matheus-1618/Esta-o_Meteorol-gica_Arduino/README.md

# Esta-o_Meteorol-gica_Arduino
Grupo: Adney Costa, Matheus Oliveira e Ykaro Andrade
* Estação que ilustrava medidas de temperatura,umidade,pressão,altitude com sensores ligados a Arduino uno.
* Projeto realizado para a disciplina do primeiro semestre do Insper, Insturmentação e Medição, com intuito mor em discutir técnicas de calibração e medição de sensores, sobretudo arduino e práticas de programação simples em Wiring, baseada sobretudo em C e C++.
* Neste repositório encontram-se também relatórios e planilhas de calibração de sensores, utilizando métodos simples como o Minimo Quadrado dos erros.
