matheus-1618/Esta-o_Meteorol-gica_Arduino/Relatório prático da estação/Relatório Estação Metereológica-Matheus,Adney,Ykaro.pdf

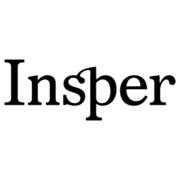
[picture p1: figure]

### Relatório Técnico

### Projeto de uma Estação Meteorológica

### Instrumentação e Medição

### Turma 1A

### Adney Costa Moura

### Matheus Silva Melo de Oliveira

### Ykaro de Sousa Andrade

### São Paulo,2020

# Objetivos e Introdução

Neste relatório será demonstrado todos os passos de como fora a montagem de Estação Meteorológica, controlada por um microcontrolador Arduino Uno, bem como todos os materiais utilizados no processo e a calibração dos respectivos sensores: Sensor de Temperatura LM-35, Sensor de Umidade DHT-22, Sensor de Luz LDR, Sensor de Pressão e Altitude BMP-358. Tudo isso afim de obter uma maior exatidão nos valores medidos em cada um dos experimentos. Para cada uma dessas medições foram realizadas experimentações em laboratório.

Com o objetivo de calibrar o Sensor LM-35 utilizamos 6 fornos, cada um com temperaturas distintas. Para a calibração DHT-22 foi preciso 6 soluções aquosas de sais distintos para a medição de umidade.

O objetivo da montagem desta Estação Meteorológica é obter os dados mais exatos possíveis de Temperatura, Umidade, Luminosidade, Altitude e Pressão e com a utilização de um microcontrolador Arduino e uma Tela LED demonstrar estesresultados, com a menor taxa de erro possível dentre os parâmetros corrigidos.

# Fundamentação teórica

Para a realização desse relatório e alguns de seus procedimentos teóricos foram utilizados conceitos matemáticos e estatísticos que auxiliaram na construção e entendimento dos dados aqui apresentados.

1.Método dos Mínimos Quadrados

Método criado por Carl Friedrich Gauss, com intuito de obter um melhor ajuste para um conjunto de dados, visando sobretudo, minimizar os erros de aproximação. Este método busca aproximar um conjunto de pares ordenados por uma função, onde cada par ordenado tem um erro de aproximação. O “MMQ” minimiza a soma dos erros quadrados, tendendo assim para uma melhor aproximação desse conjunto de dados.

Para o uso deste método, se fazem necessários os cálculos dos seguintes somatórios:

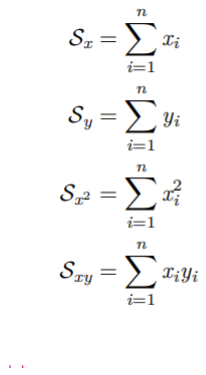
[picture p2: figure]

Posteriormente, foi estabelecido o cálculo da variável intermediária ∆, esta crucial para o estabelecimento dos coeficientes intrínsecos à reta:

∆= n. Sx² − SxSx

a =

1
∆

(nSxy − Sxy)

b =

1
∆

(nSx²Sy − SxSxy)

Definido os coeficientes, devemos definir as retas de calibração e sua função inversa, que dessa forma, permitirão uma correção de um conjunto de dados analisados:

f(x) = ax + b

f

−1

(y) = (

1
a

) . y − (

b
a

)

De posse dessas retas, se faz possível a correção de determinados valores estimados com a correção adequada para tal conjunto de valores.

2.Determinação de incertezas

De acordo com o conjunto de dados analisados, determinadas incertezas são intrínsecas a sua medição, tanto quanto à características próprias do material. Dessa forma, dois tipos de incerteza foram considerados durante todo o processo de análise e correção de conjuntos de dados, estes, posteriormente combinados em um único valor de incerteza, essa sendo considerada padrão para o sistema em questão. A primeira incerteza analisada, é concernente a erros aleatórios, essa sendo considerada como Incerteza estatística ou Incerteza do tipo A, onde seu cálculo é possível através do estabelecimento do desvio padrão da amostra de dados e seu respectivo tamanho. Os passos para sua obtenção, consistem em:

-Cálculo da média aritmética da amostra:

u =

1
n

∑xi

n

i=1
-Cálculo do desvio padrão:

σ = √
1
n − 1

∑(xi − u)²

n

i=1

-Determinação da incerteza estatística:

σa =

σ
√n

Analogamente, se faz necessário o cálculo da incerteza sistemática residual, que usualmente tem seu cálculo através da seguinte fórmula, onde L, é considerado o limite de erro do aparelho:

σb =

L
2

Assim, para a obtenção da incerteza padrão associada ao sistema, basta utilizar:

σp = √σa
2 + σb

2

3.Propagação e Transferência de incertezas

De posse dos valores das incertezas associadas a esse conjunto de valores, é necessário entender como, ao realizar operações matemáticas com dois valores que possuem incertezas, precisamos “propagar” as incertezas associadas. Esse processo, em todas as operações possíveis podem ocorrer conforme a tabela abaixo:

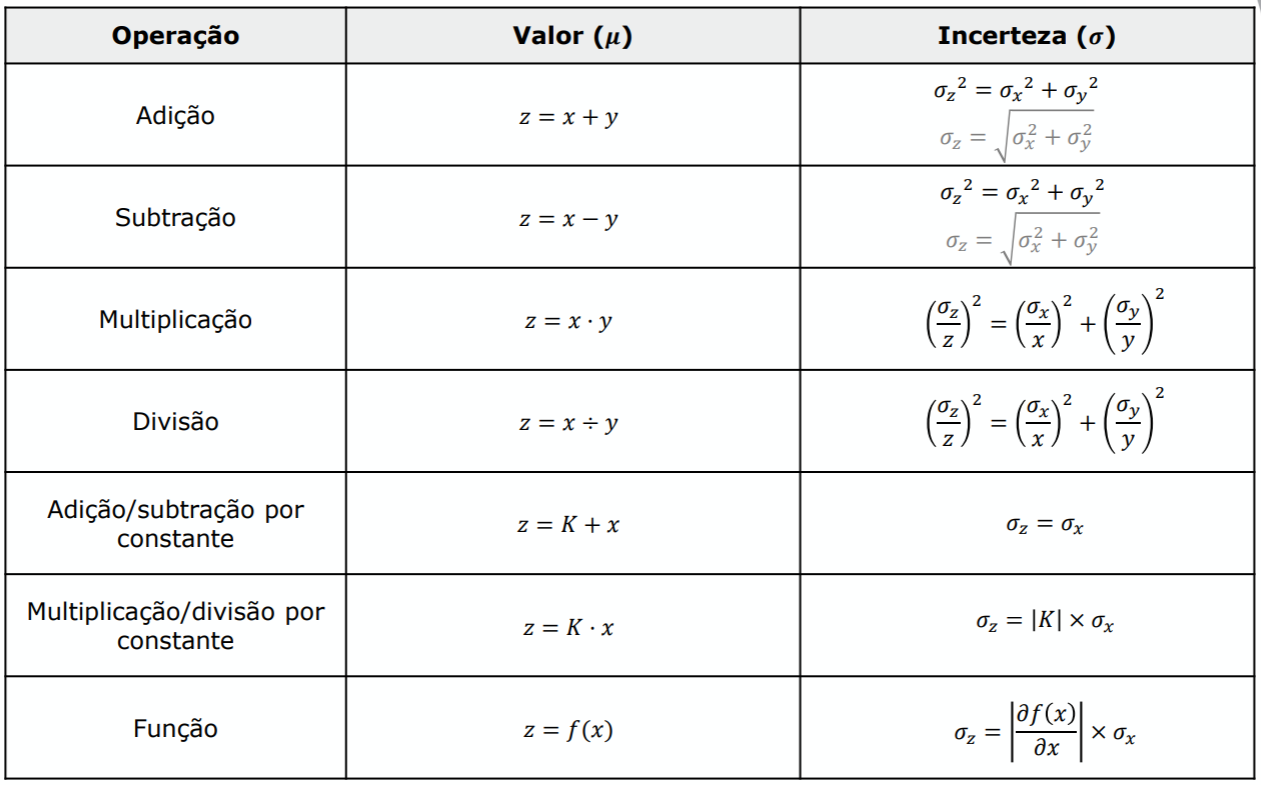
[picture p3: figure]

Eventualmente, determinadas grandezas são medidas em função de determinadas variáveis independentes, sendo que ambas as grandezas podem possuir incertezas associadas. Nesse caso, é necessário admitir-se que a incerteza associada a variável dependente é maior dada pela expressão:

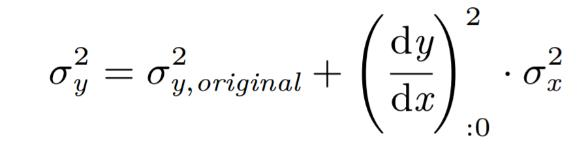
[picture p4: figure]

Assim, utilizando um algoritmo dentro da plataforma Microsoft Excel, se faz possível a transferência de incertezas de eixos.

4.Métódo dos mínimos quadrados com incertezas

Com os valores de incertezas associadas às amostras em mãos, faz-se necessário a adaptação da utilização do MMQ para uma melhor análise disposta do conjunto de dados em questão. Para tal, algumas adaptações algébricas são realizadas e mostradas abaixo, todavia, o algoritmo de resolução da variável intermediária e seus consequentes coeficientes continuam os mesmos.

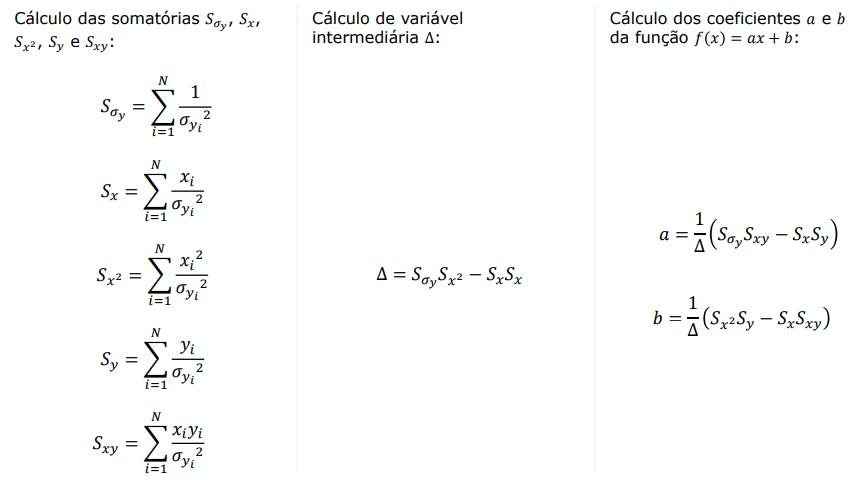
[picture p5: figure]

5.Interpolação e extrapolação

Método que dada a linearidade de uma amostra de dados e seus respectivos valores, pode associar medidas esperadas utilizando tanto valores já definidos, quanto valores esperados pela reta associada. A validade deste método se baseia sobretudo na utilização geométrica de semelhança de triângulos que conseguem prever medidas aproximadas para valores interpolados entre dois pontos conhecidos, como no caso da interpolação ou na suposição de um valor definido e um suposto para com outro esperado entre esses.

# Materiais e métodos

1.Materiais, hadwares e softwares utilizados

A estação é composta de 4 sensores: Temperatura, Altitude e Pressão, Umidade e Luminosidade. Para realizar a calibração de alguns sensores e montagem do projeto foram utilizados os seguintes materiais ou instrumentos:

- 2 Protoboards 830 furos, Breabodboard MB-102;
- 1 resistor de 330ꭥ;
- 1 resistor de 1kꭥ;
- 1 resistor de 10kꭥ;
- 1 Arduino Uno R3 original;
- 1 cabo USB – AB;

-1 display de Cristal Líquido-LCD;

- 1 sensor de Temperatura LM35;
- 1 sensor de umidade DHT 22;
- 1 sensor de luminosidade LDR;
- 1 sensor de altitude e pressão BMP280;
- Termômetro Vidro Líquido Vermelho 5021 Incoterm (53011/15);
- 6 fornos de calibração Ecil;
- 6 Termômetros (Termorresistência) Digital Instrutemp ITTM-917;
- 6 soluções aquosas de sais. Sendo elas:
- Acetato de Potássio
- Cloreto de Magnésio
- Cloreto de Sódio
- Hidróxido de Potássio
- Nitrato de Cálcio
- Cloreto de Potássio

O seguinte software fora utilizado para o registro e análise dos dados coletados durante o experimento: -Microsoft Excel 2016 (pacote Office 2016).

Fora utilizado o software Arduino 1.8.13 para depuração do código utilizado, no qual estão presentes as calibrações realizadas pelos métodos explicados neste relatório posteriormente.

2.Montagem, calibração e métodos utilizados

Inicialmente, fora realizada a calibração do sensor LM35, cujo intuito mor era a medição da temperatura do ambiente. Para esse ajuste, foram realizadas seis medições de temperatura em 6 fornos de calibração, com respectivas temperaturas em 5°C, 15°C, 30°C, 45°C, 60°C e 75°C. Fora adotado um tempo de medição padrão para todas as medições, este estabelecido em aproximadamente quatro minutos. Durante o experimento, os três integrantes da equipe realizaram suas respectivas medições de forma individual e registraram seus resultados no computador, por meio da porta Serial do software Arduino. Porém, para a padronização de todas as aferições, fora escolhido os dados coletados de apenas um dos integrantes, por terem maior proximidade com a realidade. Além disso, fora realizado o trajeto de aferição no sentido do forno com maior temperatura, estimada em 75°C, rumo ao de menor, esperada com temperatura de 5°C, este escolhido com objetivo principal de diminuir o tempo de estabilização do sensor.

Posteriormente, com os dados coletados, fora realizada uma análise e registro na plataforma Microsoft Excel, no qual, após o estabelecimento dos padrões de medição, fora realizada a propagação de incertezas durante o cálculo da média amostral, Desvio padrão e suas respectivas incertezas, do tipo A e B, permitindo assim, uma maior exatidão no estabelecimento da reta de calibração por meio do Método dos Mínimos. Com posse dos dados da reta de calibração, gerando uma função de correção para o valor obtido e pelo real, assim como seus coeficientes, fora possível gerar um padrão de correção, utilizado no código implantado no Arduino.

Subsequentemente, fora realizada a calibração do sensor de umidade, DHT22, utilizando seis soluções salinas, com objetivo de aferir diferentes valores de umidade relativa.

Durante a experiência, foram realizadas seis medições de umidade e temperatura em 6 Becker’s, cada qual contendo uma solução aquosa saturada de seis sais distintos para a calibração e a aferição base do experimento. Fora adotado um tempo de medição padrão para todas as medições, este estabelecido em aproximadamente dez minutos, focado sobretudo na estabilização das medições. Durante o experimento, um dos integrantes da equipe realizou o experimento de forma individual, enquanto os outros dois integrantes realizaram de forma conjunta o registro das medições em seu computador por meio da porta Serial Arduino, depois registrando esses em um documento do tipo CSV, para posterior análise no Excel.

O trajeto de aferição fora escolhido no sentido da solução de menor valor de umidade esperado para o de maior valor de umidade esperado, sendo respectivamente o Hidróxido de Potássio e o Cloreto de Potássio, com objetivo de facilitar a medição, e manter o tempo de estabilização próximo da constância estabelecida previamente.

Ulteriormente, os dados das umidades coletadas foram analisados e registrados na plataforma Microsoft Excel, no qual, fora possível realizar os processos de propagação de incerteza, transferência de incerteza, cálculo das médias das amostras, desvio padrão e as respectivas incertezas de tipo A e B, e dessa forma, o estabelecimento de uma reta de calibração, por meio do Método dos Mínimos Quadrados, que ao minimizar os erros de medição, nos gera uma boa aproximação dos valores corrigidos de umidade registrados para com aqueles condizentes com a realidade.

Realizada a calibração destes dois sensores, fora iniciada a montagem da estação meteorológica, utilizando além dos já citados, um display de cristal líquido e sensores de luminosidade, altitude e pressão; todos esses funcionando sobre o Protocolo I2C, no qual o microcontrolador Arduino Uno R3 funciona como “mestre” para estes, iniciando e controlando a comunicação das portas analógicas de maneira síncrona.

Para a montagem foram utilizadas a porta A0, associado a um resistor de 1kΩ que realizara a leitura de tensão obtida pelo sensor LM35, e suas respectiva conversão para graus Celsius, no qual fora a utilizada a seguinte conversão:

10mV = 1°C

Fora utilizada ainda a resolução de Quantização, utilizando como tensão de alimentação máxima como 1,1 V, e a maior contagem de intervalos discretos, aproximada para:

2

n − 1

Assim, fora possível obter-se uma resolução de discretização, da seguinte forma, sendo 1,1 V, o fundo de escala escolhido:

δ =

1,1
2

n − 1

=

1,1
1023
δ°C ≈ 0,1075°C

Esta última fora fundamental para obtenção da temperatura medida pelo sensor, e que posteriormente sofrera correção pela reta de calibração obtida. De posse dessa última também é possível estimar-se a incerteza associada ao microcontrolador Arduino, do tipo B:

σarduino ≈ 0,2151°C

Assim, de acordo com os dados do fabricante Arduino, e do sensor LM35, teremos as respectivas incertezas associadas.

Combinando essas incertezas, e posteriormente as combinando com a incerteza associada a erros aleatórios de medição fora possível estimar a incerteza padrão associada a cada medição do sensor, este processo contando coma utilização do Método dos Mínimos quadrados, associada as incertezas propagadas durante a realização das operações necessárias à sua calibração.

Posteriormente, fora realizada a montagem do sensor de umidade, DHT22, este ligado na porta pin 2, necessitando do uso de um resistor ôhmico de 10kΩ. Para a medição da umidade relativa em questão era necessário o estabelecimento de uma temperatura de referência, para que, com esta fosse suposta a porcentagem de umidade em relação a umidade máxima naquele momento. Para sua calibração, foram utilizados os processos de interpolação e extrapolação, para suposição de valores intermediários aos de referência, transferência de incertezas, para obtenção de uma incerteza padrão mais próxima da realidade após a transferência desta por eixos distintos conforme mostrado no decorrer deste relatório, e por fim a utilização do Método dos mínimos quadrados associados à propagação de incertezas para obtenção de uma reta de calibração ideal às medições esperadas do sensor.

Subsequentemente, foi iniciada a montagem dos sensores e visor LCD por meio do protocolo I2C, no qual utilizando dois fios, em entradas dos tipos SCL e SDA e dois outros fios de alimentação, provém uma comunicação síncrona entre o microcontrolador e os dispositivos associados a este. Estes
sensores, | respectivamente | BMP | 280 | e | LDR, | foram | responsáveis,
respectivamente, pela aferição de altitude e pressão atmosférica; e luminosidade do ambiente em questão. O sensor de luminosidade LDR, em sua montagem na estação contou com a utilização de um resistor de 330Ω, para assim, diminuir a tensão efetiva neste, e evitar possíveis sobrecargas.

Feita a montagem dos sensores, fora necessário a utilização do visor LCD para ilustração dos valores aferidos em tempo real. Este funcionara com um endereçamento de 16x2, do tipo alfanumérico, especializado em mostrar caracteres do tipo ASCII. Assim, na escrita do algoritmo utilizado era necessário estipular-se o tempo de exibição, tal qual o endereço de exibição em bits do valor requerido

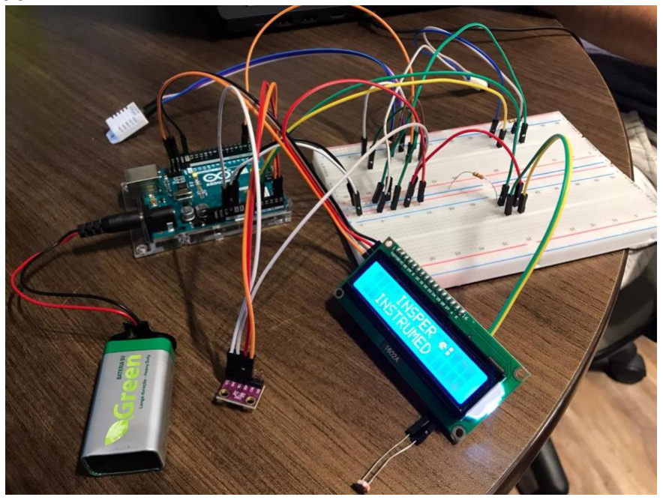
[picture p6: figure]

Figura 1-Visão geral da estação montada

### 3. Programação e algoritmos

Para o eficaz funcionamento da estação, foi necessário a elaboração do código de programação em linguagens C,C++ e C#, por meio da plataforma de prototipagem livre Wiring, em especifico pelo Arduino. Por meio deste código fora possível ajustar as medições previstas pelas retas de calibração obtidas pelos métodos já explicitados, além de ajustar parâmetros de endereçamento e exibição no visor LCD, tornando assim a ilustração dos valores de medição, mais práticos e usuais a aqueles que farão uso da estação.

O código conta com cerca de 3 subdivisões, a primeira na qual são importadas/incluídas as bibliotecas dos sensores e visor utilizados na montagem, além da definição das constantes utilizadas, portas utilizadas, pinagem e confecção de possíveis símbolos não dispostos nos caracteres ASCII, como o símbolo de grau, utilizado na ilustração de temperatura. Posteriormente, foi executada a função void setup(), na qual fora iniciado o programa, assim como o funcionamento dos sensores e visor, tal qual a definição da porta analógica de referência. Por fim, é mostrada a função void loop(), na qual foram definidos os comandos, leituras e medições que serão mostrados de forma indefinida pelo LCD ou monitor Serial. Nele são especificados quais “strings” deveram ser mostradas, tempos de intervalo, conversões realizadas para medições, assim como possíveis definições de fundo de escala ou resoluções.

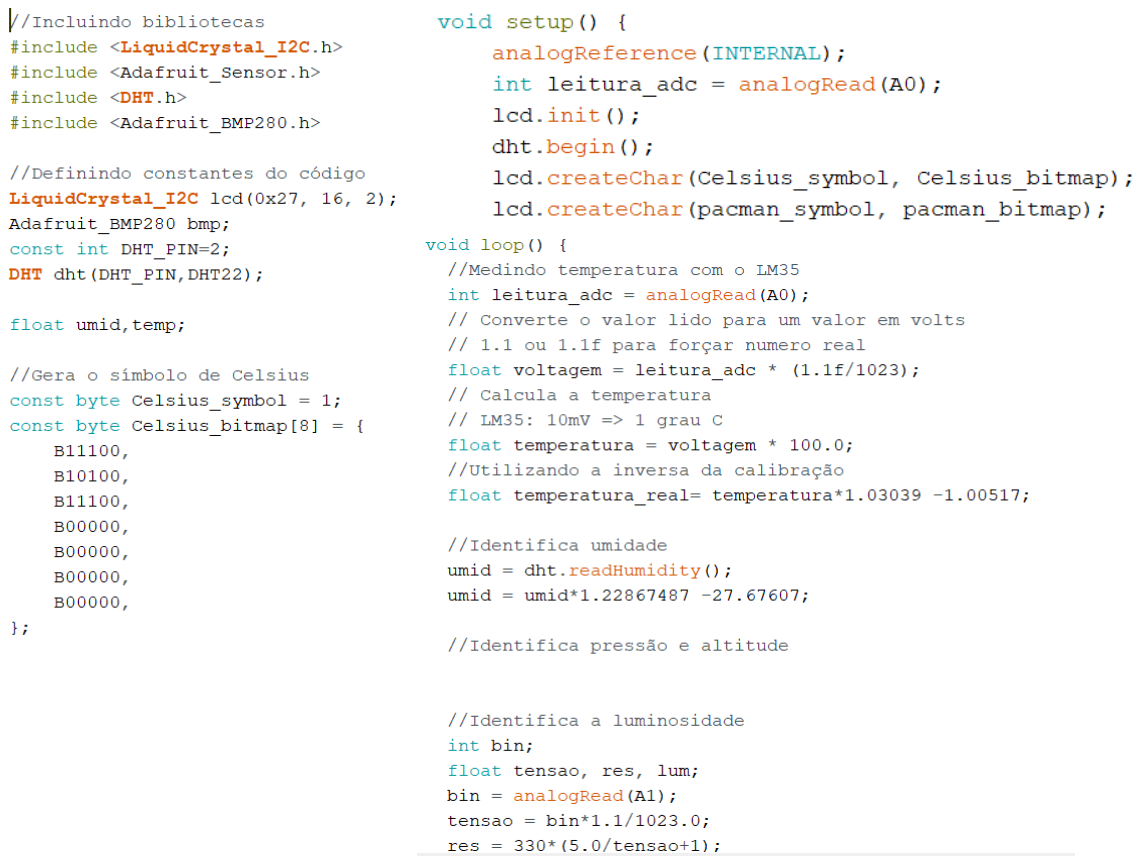
[picture p7: figure]

Figura 2-Parte do código utilizado

# Resultados e discussões

Concomitantemente, foram coletados dados que depois de remetidos às análises, calibrações e montagens, geraram resultados interessantes que possibilitaram a montagem com êxito da estação. Estes resultados foram dividos de acordo com a medição de cada sensor disposto abaixo.

### 1. Sensor de temperatura-LM35

Para a captação dos dados de temperatura registrados pelo sensor LM35, este fora colocado em contato com cerca de 6 fornos de calibração dispostos no laboratório, nas seguintes temperaturas: 5°C, 15°C, 30°C, 45°C, 60°C e 75°C. Ao lado de cada forno havia uma termo resistência que servira como referência para possíveis calibrações em relação ao indicado pelo LM35. Para a medição, fora adotado um tempo médio de espera, estipulado em cerca de 4 minutos para a estabilização das medições. A sequência escolhida para aferição se iniciou do forno de menor temperatura rumo ao de maior temperatura, com intuito de minimizar o tempo de estabilização do sensor, tal qual evitar possíveis erros de medição gerados por uma maior diferença de amplitude nas medições, caso escolhida outra ordem.

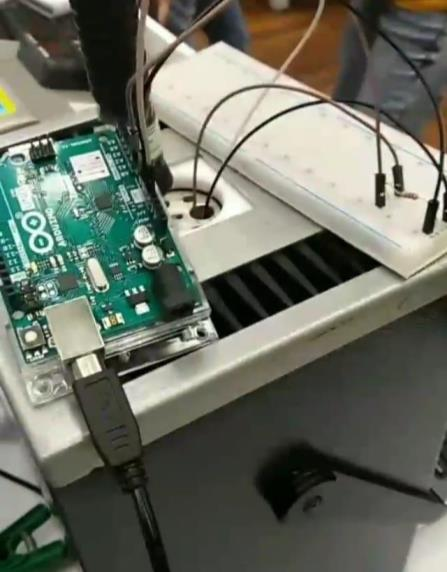
[picture p8: figure]

Figura 3-Sensor registrando a temperatura aproximada em um forno de calibração

Após a coleta dos dados de temperatura para cada um dos fornos, foram consideradas cerca de 5 medições para cada forno. Estes, foram registrados em uma planilha no software Microsoft Excel. Neste também foram registrados os valores de referência, dispostos nas termo resistências auxiliares.

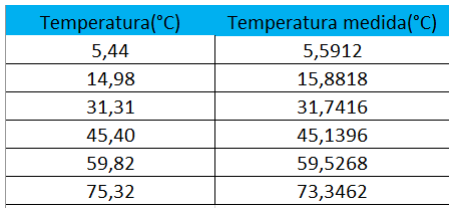
[picture p9: figure]

Tabela 1-Na primeira coluna temos a indicação da temperatura pela termo resistência e na direita, a indicada pelo sensor

Posteriormente, para a estimativa das incertezas associadas, assim como a confecção da reta de calibração, foi realizada, inicialmente, a média aritmética de cada amostra, possibilitando assim, a estimativa do desvio padrão de cada temperatura aferida pelo sensor, e com este, foi possível a estimativa da Incerteza estatística. A incerteza residual sistemática foi estabelecida de acordo com dados fornecidos pelo fabricante, e pelo fundo de escala utilizado, no caso em específico de 1,1V, conforme especificado na seção de Materiais e Métodos.

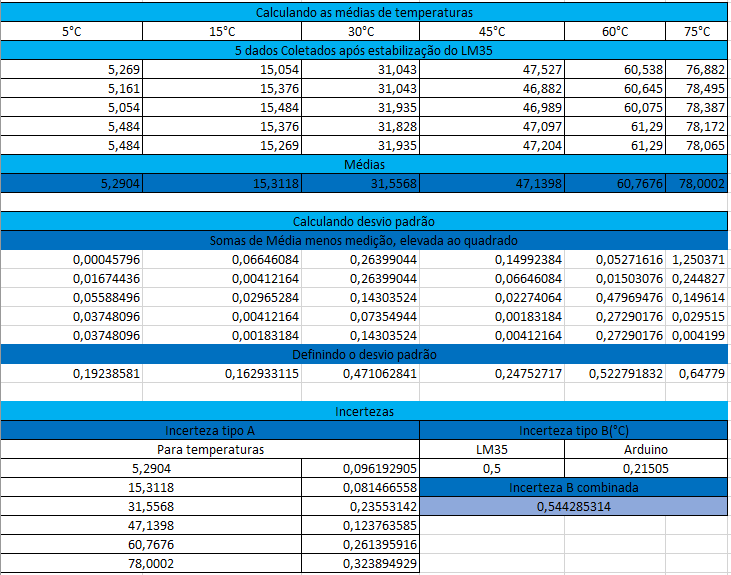
[picture p10: figure]

Tabela 2-Médias aritméticas, Desvio Padrão e Incertezas associadas as amostras.

De posse das incertezas tipo A e B, fora possível combiná-las para obtenção das incertezas padrões de cada temperatura aferida.

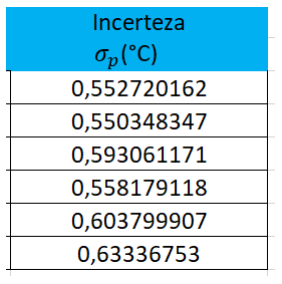
[picture p11: figure]

Tabela 3-Incertezas padrões de cada faixa de temperatura aferida

Destarte, foi possível com a utilização do Método dos Mínimos Quadrados com propagação de incertezas, já explicitado na seção de Fundamentação teórica, foram obtidos os respectivos coeficientes intrínsecos a reta de calibração, necessária para polidez da amostra de dados coletadas.

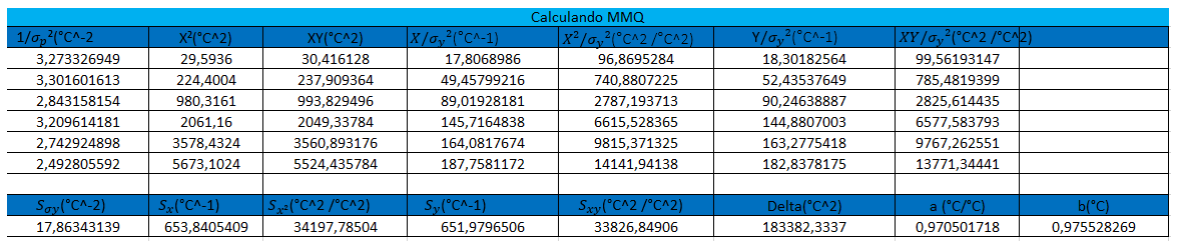
[picture p12: figure]

Tabela 4-Algoritmo de realização dos cálculos pelo MMQ com propagação de incertezas

Dessa forma, foram obtidos tanto a função de calibração, quanto sua inversa, utilizada no código para correção.

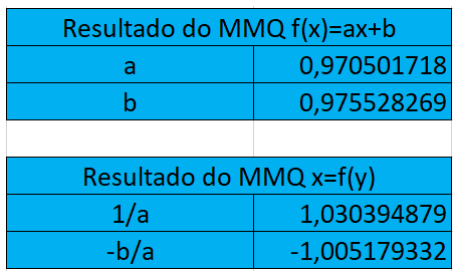
[picture p13: figure]
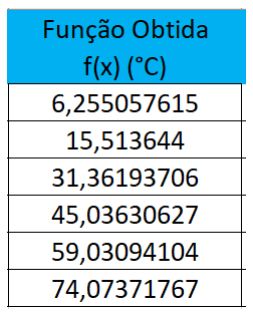
[picture p14: figure]

Tabelas 5 e 6: Equações das retas de calibração, e resultados práticos de calibração para cada ponto amostral.

Dessa forma, fora obtida uma reta de calibração que trouxeram maior proximidade dos dados coletados para com o valor esperado por meio da correção gerada pelos passos explicitados.
Figura 4-Gráfico com representação da reta de calibração

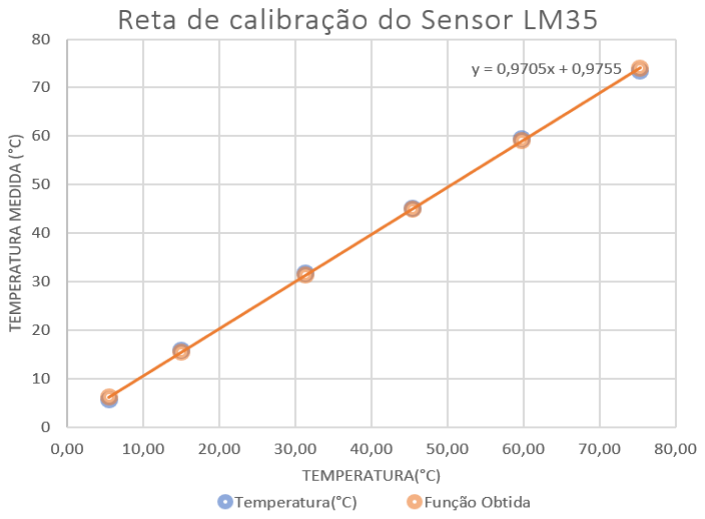
[picture p15: figure]

Em termos práticos, a equação da reta é apresentada abaixo:

y = 0,9705x + 0,9755

Fora realizado a percentualidade do erro relativo nesta medição, em relação a medição esperada, tomando como base a temperatura na faixa de 15°C:

e =

|15 − (0,9705(15) + 0,9755)| (0,9705(15) + 0,9755)

e = 0,0343

Dessa forma, percebe-se que o eixo percentual se encontra próximo de 3,43%, o que se configura com um ótimo grau de razoabilidade da calibração.

No código utilizado para o microcontrolador, essa calibração foi feita aplicando a função inversa da apresentada acima, devido a conversão do valor medido para o esperado. Esta é mostrada a abaixo:

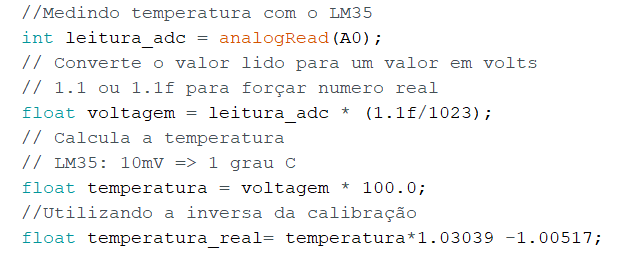
[picture p16: figure]

Figura 5-Parte do código onde ocorre a correção do valor medido

### 2. Sensor de Umidade- DHT22

Tal sensor fora submetido a diferentes porcentagens de umidade relativa, variadas devido a solubilidade das soluções em questão, na qual foram dispostas 6 soluções salinas, estas já apresentadas anteriormente. O sensor fora colocado em recipientes cujo intuito era minimizar o efeito do ambiente sobre a medição no Becker. Dessa forma foram coletadas cerca de 5 medições de umidade para cada solução salina, após sua estabilização. Para tal estabilização, fora definido um tempo comum de aferição estabelecido em volta de 10 minutos. Para minimizar erros experimentais gerados por uma maior diferença de amplitude de medição, fora adotado o sentido de aferir-se as soluções com umidades esperadas mais altas, isto é, próximas de 100%, rumo as baixas, mais próximas de 5%.

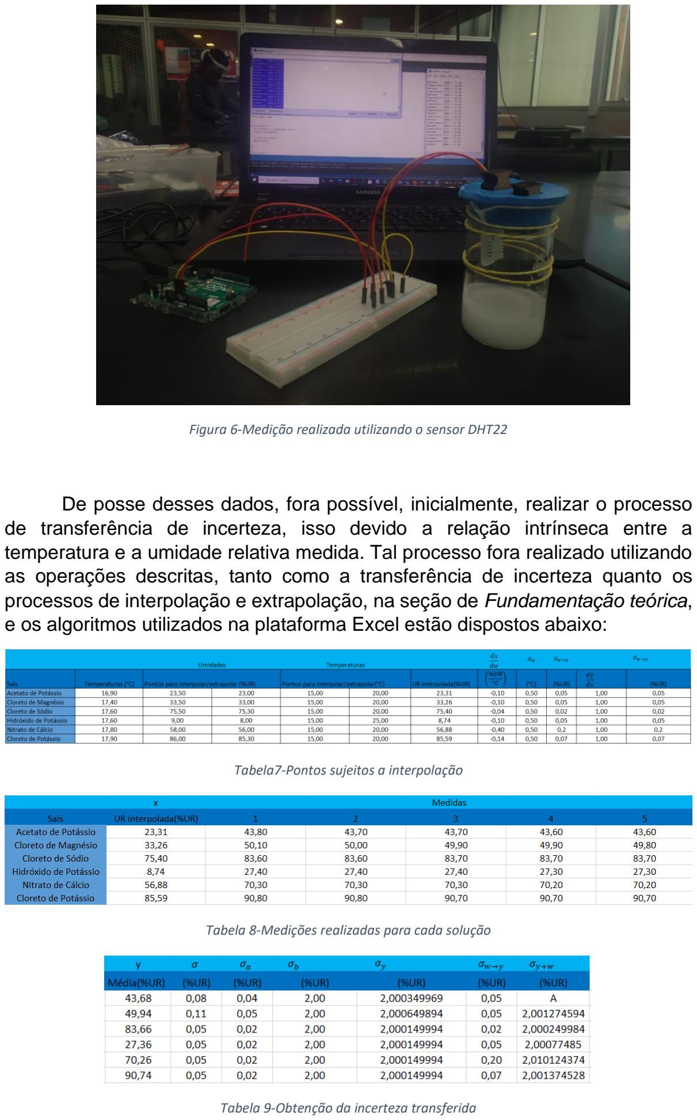
[picture p17: page 16]

Figura 6-Medição realizada utilizando o sensor DHT22

De posse desses dados, fora possível, inicialmente, realizar o processo de transferência de incerteza, isso devido a relação intrínseca entre a temperatura e a umidade relativa medida. Tal processo fora realizado utilizando as operações descritas, tanto como a transferência de incerteza quanto os processos de interpolação e extrapolação, na seção de Fundamentação teórica, e os algoritmos utilizados na plataforma Excel estão dispostos abaixo:

Tabela7-Pontos sujeitos a interpolação

Tabela 8-Medições realizadas para cada solução

Tabela 9-Obtenção da incerteza transferida

Obtida a incerteza transferida padrão, foi possível realizar-se o Método dos Mínimos Quadrados com propagação de incertezas, que dessa forma, pode nos conferir uma reta de calibração que trouxera maior proximidade dos dados coletados para com as referências estipuladas.

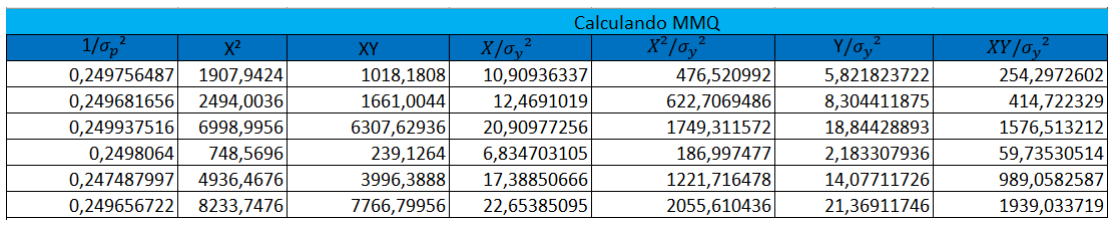
[picture p18: figure]
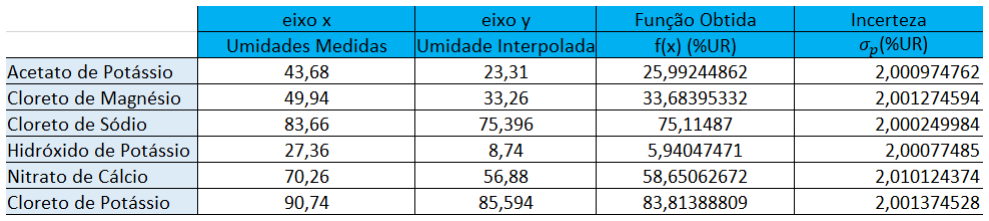
[picture p19: figure]

Tabela 13-Comparação entre medição e calibração dos dados obtidos

Desse modo, foi possível plotar-se o gráfico da reta de calibração, que gerara com maior precisão e exatidão os pontos de medição do sensor.

Tabela 10-Algoritmo para cálculo do MMQ

Tabela 11-Obtenção dos somatórios e coeficientes necessários

Tabela 12-Coeficientes obtidos

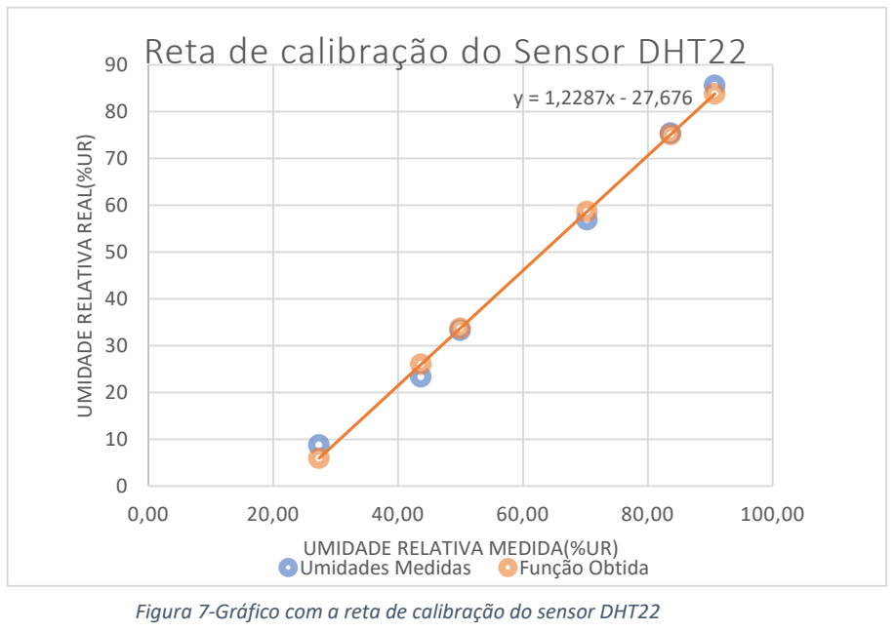
[picture p20: figure]
UMIDADE RELATIVA REAL(%UR); UMIDADE RELATIVA MEDIDA(%UR); Reta de calibração do Sensor DHT22; Umidades Medidas; Função Obtida

Figura 7-Gráfico com a reta de calibração do sensor DHT22

Buscando estipular a faixa de erro percentual associado a função de calibração medida em relação a umidade interpolada esperada, chegamos a um erro percentual aproximado de 11,5%, variando de acordo com o ponto de medição analisado. Nota-se que esse erro aumenta gradualmente ao menor valor de umidade aferido. Esses se minimizam conforme a percentualidade da umidade relativa aumenta, tendendo ao 100%.

Dessa forma, foi possível, durante a programação destinada ao microcontrolador, corrigir esse conjunto de valores, aplicando assim a inversa da reta obtida acima:

Figura 8-Parte do código onde ocorre a correção do valor medido

### 3. Sensor de Altitude e Pressão atmosférica- BMP 280

Para aferição da altitude e pressão atmosférica, fora utilizado o sensor BMP280, produzido pela Bosch. Este funciona segundo o protocolo I2C, conforme explicitado em seções anteriores. Está sujeito a uma incerteza de aproximadamente 0,12 Hectopascal de pressão atmosférica. Sua medição era informada, originalmente, na medida de Pascal, todavia, como a medida mais usual utilizada é o atm, fora realizada uma conversão própria dentro do código que possibilita-se essa visão.

### 4. Sensor de Luminosidade- LDR

O sensor responsável pela aferição da luminosidade é o LDR, que consiste basicamente em uma resistência que varia de acordo com a intensidade luminosa do local. Destarte, esse sensor não necessita de uma fonte de alimentação, precisando apenas de uma divisão de tensão que permita a leitura dessa tensão na entrada analógica do Arduino.

### 5. Display de Cristal Líquido

O LCD utilizado consiste basicamente de um circuito eletrônico baseado em um microcontrolador interno dedicado à exibição visual. Para essa exibição utiliza-se caracteres ASCII, que permitem a escrita de vários tipos de “strings”, valores e sinais, salvo algumas exceções. O display é alimentado com uma voltagem de 5V, e tem ligações SDA e SCL, conforme especificado pelo protocolo I2C.

### 6. Montagem da estação

Explicitados os sensores e displays utilizados na montagem da estação, destaca-se também a montagem na protoboard de todos esses em conjunto, buscando, sobretudo, ligações que conectassem sensores e visor cuja ligação/alimentação sejam as mesmas. Na montagem também fora levado em conta a melhor disposição dos circuitos com intuito maior de evitar problemas de medição nestes gerados por diminuição da superfície de captação ou por problemas de “mal contato”. Dessa forma, foram utilizadas duas placas Protoboard associadas, com intuito de aumentar a amplitude das ligações na placa, e assim evitar possíveis contatos e disposições erradicas. Assim, fora ligado no terminal positivo da Protoboard, o “jumper” que conectara esse a saída de 5V, alimentando assim os sensores LM35 e DHT22, assim como o Display de Cristal Líquido. O sensor BMP280, foi alimentado diretamente pela saída de 3.3V, devido as especificações do fabricante. Analogamente, fora ligada ao terminal negativo, a saída GND, que dispunha de ligações com os sensores LM35, DHT22, BMP280 e display de Cristal Líquido. Ademais, fora utilizado um resistor de 10KΩ na ligação do sensor DHT22, este ligado na porta PIN 2, com intuito de tornar a medição mais próxima do real, diminuindo a corrente efetiva sobre o sensor. Já na ligação do sensor LM35, esse ligado na porta analógica A0, fora utilizado um resistor de 1KΩ, com o mesmo intuito feito no sensor anteriormente mencionado. O mesmo efeito foi suposto para a montagem do sensor de luminosidade, este, utilizando um resistor de 330Ω, e este sensor fora ligado na porta analógica A1, com intuito de gerar uma tensão de averiguação para o microcontrolador, gerando assim as medidas convertidas em lux de acordo com o código de programação. Por fim, destaca-se a ligação das entradas DAS e SCL, ou A4 e A5 para os sensores e display, que pelo protocolo I2C, necessitam do microcontrolador Arduino para o funcionamento. Esta, foi disposta com intuito de distribuição conjunta para todos esses.

A ilustração da montagem segue abaixo:

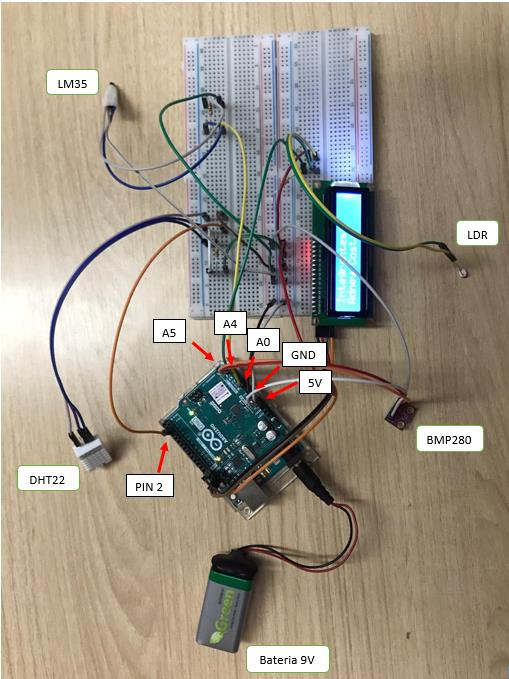
[picture p21: figure]

Figura 9-Montagem da estação

## Conclusão

Destarte, conclui-se que após montagem e realização de processos necessários para o bom funcionamento da estação explicitada nas seções acima, que essa última demonstra um grande potencial de informações a serem exibidas, consolidando uma base sólida de utilização e mesclagem de software e hadware, nas plataformas disponibilizadas, no caso, a plataforma de prototipagem livre, Arduino, e sensores também postos que configuram a estação.

É válido ressaltar-se a importância do bom balanceio de informações para uma boa execução de montagem e elaboração do código que norteia o microcontrolador, dessa forma deixando o funcionamento da estação fluído e com poucos ou nulos erros de medição, devido a boa organização na protoboard, tal qual uma boa elaboração dos protocolos que auxiliaram na leitura e transformação dos valores aferidos em medidas inteligíveis ao serem ilustradas pelo display de Cristal líquido.

Por fim, destaca-se, para a boa execução do projeto e todos os passos descritos a formalização de protocolos de trabalhos que permitam uma melhor inteiração e efetividade na coleta e tabelamento de dados que tornem o experimento mais organizado e suscetível de ser realizado, aumentando a chance de êxito na montagem.

## Referências Bibliográficas

NOVAES, Carlos. MENEGALDO, Caue Garcia. Instrumentação e MediçãoAula 13-Metrologia II. 2020: Insper.

NOVAES, Carlos. MENEGALDO, Caue Garcia. Instrumentação e MediçãoAula 14- Projeto de uma ponte de Wheastone. 2020: Insper.

NOVAES, Carlos. MENEGALDO, Caue Garcia. Instrumentação e Medição Aula 15-Metrologias III. 2020: Insper.

NOVAES, Carlos. MENEGALDO, Caue Garcia. Instrumentação e Medição Aula 16-Microcontrolador,Arduino e linguagem C. 2020: Insper.

NOVAES, Carlos. MENEGALDO, Caue Garcia. Instrumentação e Medição Aula 18-Calibração do LM35. 2020: Insper.

NOVAES, Carlos. MENEGALDO, Caue Garcia. Instrumentação e Medição Aula 19-Sensor de umidade. 2020: Insper.

NOVAES, Carlos. MENEGALDO, Caue Garcia. Instrumentação e Medição Aula 20-Calibração sensor de humidade. 2020: Insper.

NOVAES, Carlos. MENEGALDO, Caue Garcia. Instrumentação e Medição Aula 21-Protocolo I2C, sensores de pressão, luminosidade e LCD. 2020: Insper.
