matheus-1618/Esta-o_Meteorol-gica_Arduino/Calibração de sensores/Calibração DHT22.xlsx

 | eixo x | eixo y | Função Obtida | Incerteza | Calculando MMQ
 | Umidades Medidas | Umidade Interpolada | f(x) (%UR) |  |  | X² | XY
Acetato de Potássio | 43.68 | 23.31 | 25.99244862 | 2.000974762 | 0.2497564874 | 1907.9424 | 1018.1808 | 10.90936337 | 476.520992 | 5.821823722 | 254.2972602
Cloreto de Magnésio | 49.94 | 33.26 | 33.68395332 | 2.001274594 | 0.2496816559 | 2494.0036 | 1661.0044 | 12.4691019 | 622.7069486 | 8.304411875 | 414.722329
Cloreto de Sódio | 83.66 | 75.396 | 75.11487 | 2.000249984 | 0.2499375156 | 6998.9956 | 6307.62936 | 20.90977256 | 1749.311572 | 18.84428893 | 1576.513212
Hidróxido de Potássio | 27.36 | 8.74 | 5.94047471 | 2.00077485 | 0.2498064 | 748.5696 | 239.1264 | 6.834703105 | 186.997477 | 2.183307936 | 59.73530514
Nitrato de Cálcio | 70.26 | 56.88 | 58.65062672 | 2.010124374 | 0.2474879968 | 4936.4676 | 3996.3888 | 17.38850666 | 1221.716478 | 14.07711726 | 989.0582587
Cloreto de Potássio | 90.74 | 85.594 | 83.81388809 | 2.001374528 | 0.249656722 | 8233.7476 | 7766.79956 | 22.65385095 | 2055.610436 | 21.36911746 | 1939.033719
 |  |  |  |  |  |  |  |  |  | Delta | a | b
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
