matheus-1618/Esta-o_Meteorol-gica_Arduino/Calibração de sensores/Calibração LM35_final.xlsx

eixo x | eixo y | Função Obtida | Incerteza |  |  | Calculando MMQ
Temperatura(°C) | Temperatura medida(°C) | f(x) (°C) |  |  |  |  | X²(°C^2) | XY(°C^2)
5.44 | 5.5912 | 6.255057615 | 0.552720162 |  |  | 3.273326949 | 29.5936 | 30.416128 | 17.8068986 | 96.8695284 | 18.30182564 | 99.56193147
14.98 | 15.8818 | 15.513644 | 0.5503483465 |  |  | 3.301601613 | 224.4004 | 237.909364 | 49.45799216 | 740.8807225 | 52.43537649 | 785.4819399
31.31 | 31.7416 | 31.36193706 | 0.593061171 |  |  | 2.843158154 | 980.3161 | 993.829496 | 89.01928181 | 2787.193713 | 90.24638887 | 2825.614435
45.40 | 45.1396 | 45.03630627 | 0.5581791178 |  |  | 3.209614181 | 2061.16 | 2049.33784 | 145.7164838 | 6615.528365 | 144.8807003 | 6577.583793
59.82 | 59.5268 | 59.03094104 | 0.6037999068 |  |  | 2.742924898 | 3578.4324 | 3560.893176 | 164.0817674 | 9815.371325 | 163.2775418 | 9767.262551
75.32 | 73.3462 | 74.07371767 | 0.6333675296 |  |  | 2.492805592 | 5673.1024 | 5524.435784 | 187.7581172 | 14141.94138 | 182.8378175 | 13771.34441
 |  |  |  |  |  |  |  |  |  |  | Delta(°C^2) | a (°C/°C) | b(°C)
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
