matheus-1618/Esta-o_Meteorol-gica_Arduino/Calibração de sensores/Transferência de incerteza-DHT22.xlsx

 |  | Umidades |  | Temperaturas
Sais | Temperaturas (°C) | Pontos para interpolar/extrapolar (%UR) |  | Pontos para interpolar/extrapolar(°C) |  | UR interpolada(%UR) |  | (°C) | (%UR) |  | (%UR)
Acetato de Potássio | 16.90 | 23.50 | 23.00 | 15.00 | 20.00 | 23.31 | -0.10 | 0.50 | 0.05 | 1.00 | 0.05
Cloreto de Magnésio | 17.40 | 33.50 | 33.00 | 15.00 | 20.00 | 33.26 | -0.10 | 0.50 | 0.05 | 1.00 | 0.05
Cloreto de Sódio | 17.60 | 75.50 | 75.30 | 15.00 | 20.00 | 75.40 | -0.04 | 0.50 | 0.02 | 1.00 | 0.02
Hidróxido de Potássio | 17.60 | 9.00 | 8.00 | 15.00 | 25.00 | 8.74 | -0.10 | 0.50 | 0.05 | 1.00 | 0.05
Nitrato de Cálcio | 17.80 | 58.00 | 56.00 | 15.00 | 20.00 | 56.88 | -0.40 | 0.50 | 0.2 | 1.00 | 0.2
Cloreto de Potássio | 17.90 | 86.00 | 85.30 | 15.00 | 20.00 | 85.59 | -0.14 | 0.50 | 0.07 | 1.00 | 0.07
 | x | Medidas |  |  |  |  | y
Sais | UR interpolada(%UR) | 1 | 2 | 3 | 4 | 5 | Média(%UR) | (%UR) | (%UR) | (%UR) | (%UR) | (%UR) | (%UR)
Acetato de Potássio | 23.31 | 43.80 | 43.70 | 43.70 | 43.60 | 43.60 | 43.68 | 0.08 | 0.04 | 2.00 | 2.000349969 | 0.05 | A
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
