matheus-1618/Esta-o_Meteorol-gica_Arduino/(commit log)

2021-03-01 Weather Station
    [Calibração DHT22.xlsx, Calibração LM35_final.xlsx, Transferência de incerteza-DHT22.xlsx, dados.csv]
2021-04-10 modificando rotina de dados
